Konik-ai/Konik-openpilot-harness-cables/car_harness/v1 (26pin_cables)/Ford_Q4_harness.pdf

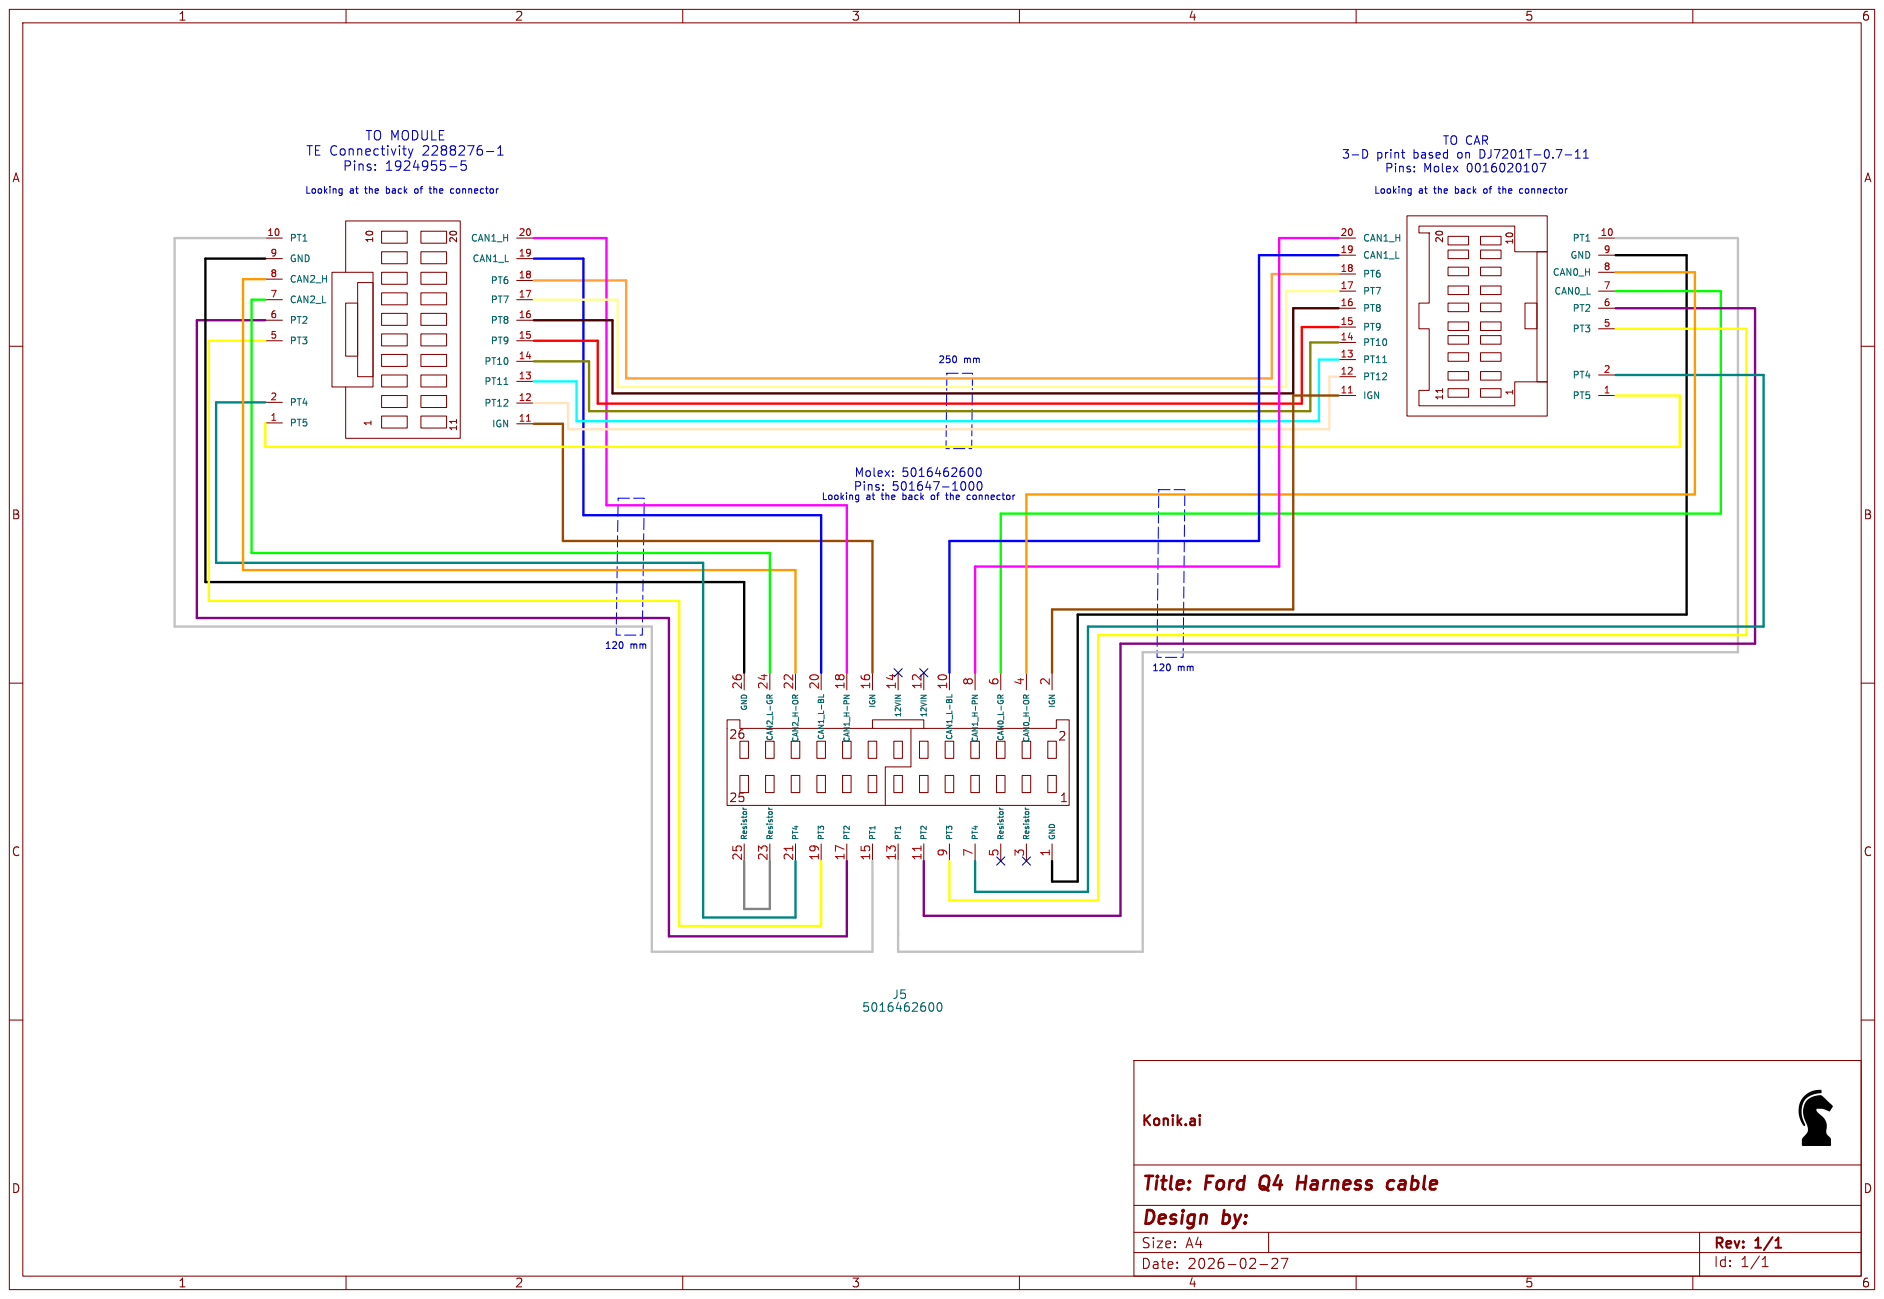
[picture p1: page 1]

3-D print based on DJ7201T-0.7-11 Pins: Molex 0016020107

Konik.ai Design by:

Id: 1/1 Title: Ford Q4 Harness cable
