Konik-ai/Konik-openpilot-harness-cables/car_harness/v1 (26pin_cables)/Bosch-C_harness.pdf

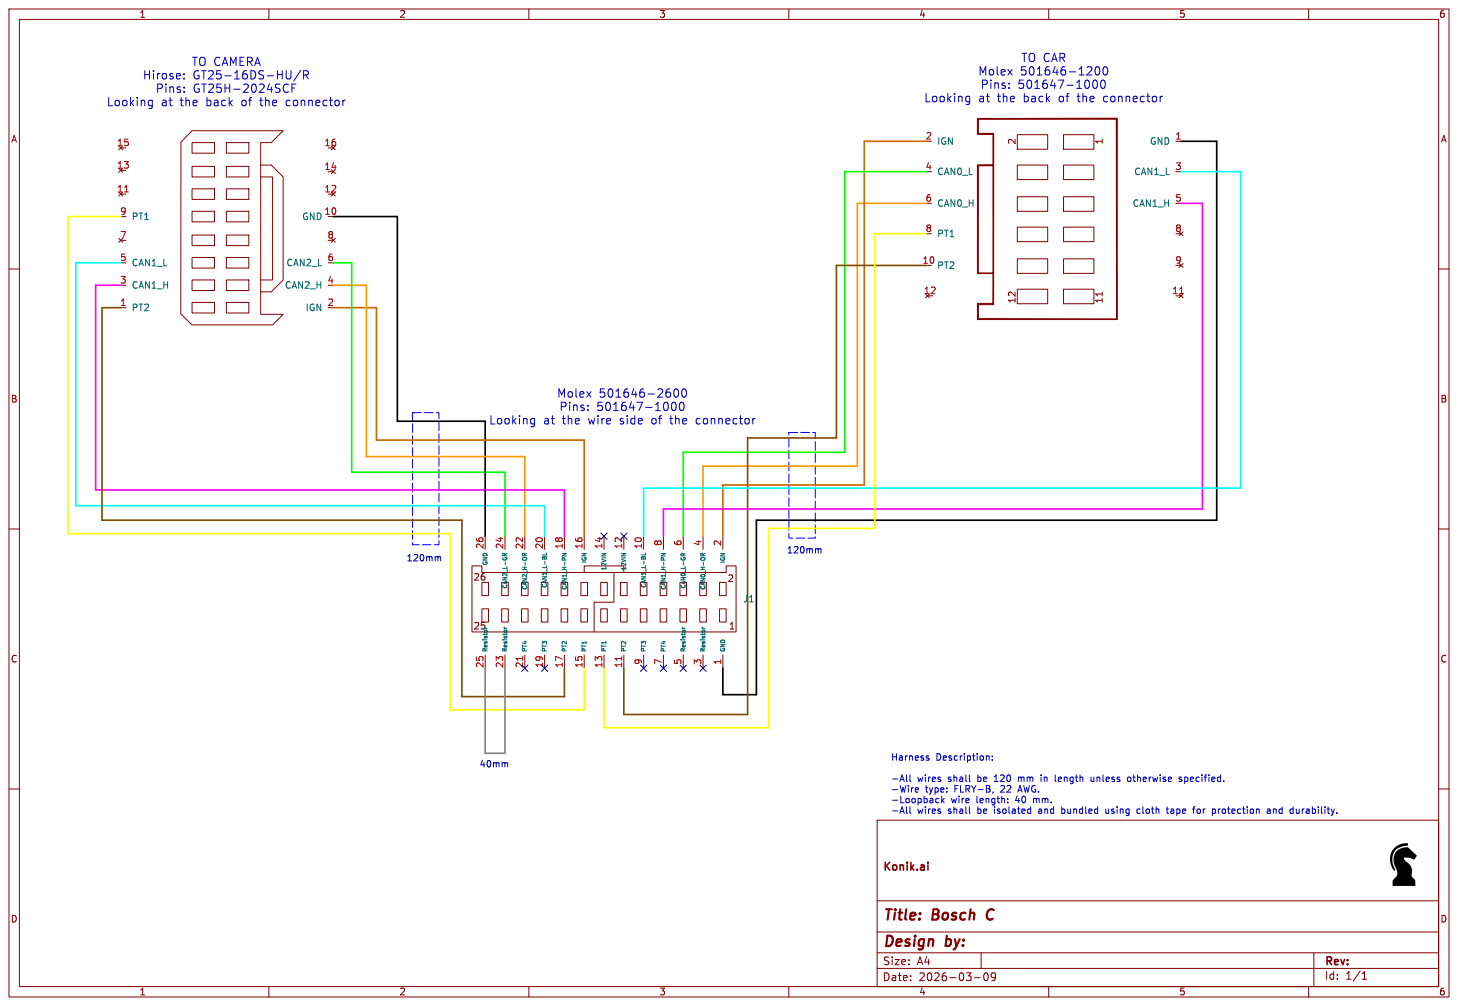
[picture p2: page 1]

Looking at the back of the connector TO CAMERA

Konik.ai Design by:
