Konik-ai/Konik-openpilot-harness-cables/car_harness/v1 (26pin_cables)/Hyundai_AKLM.pdf

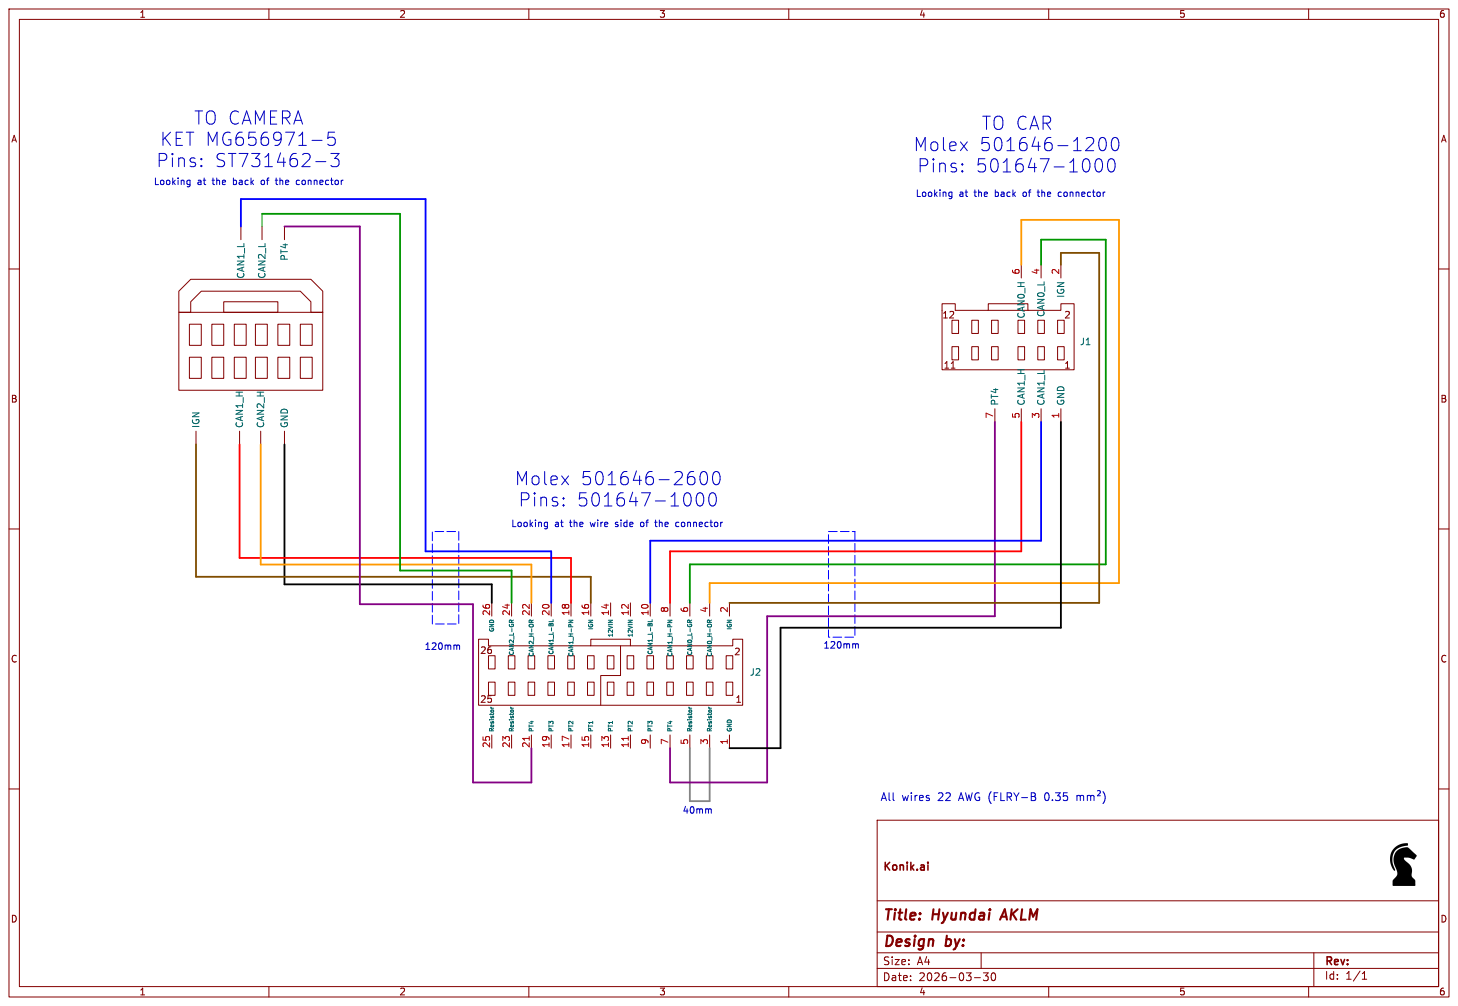
[picture p3: page 1]

Looking at the wire side of the connector

Konik.ai Design by:

Id: 1/1 Title: Hyundai AKLM
