Konik-ai/Konik-openpilot-harness-cables/car_harness/v1 (26pin_cables)/Hyundai_BEGI.pdf

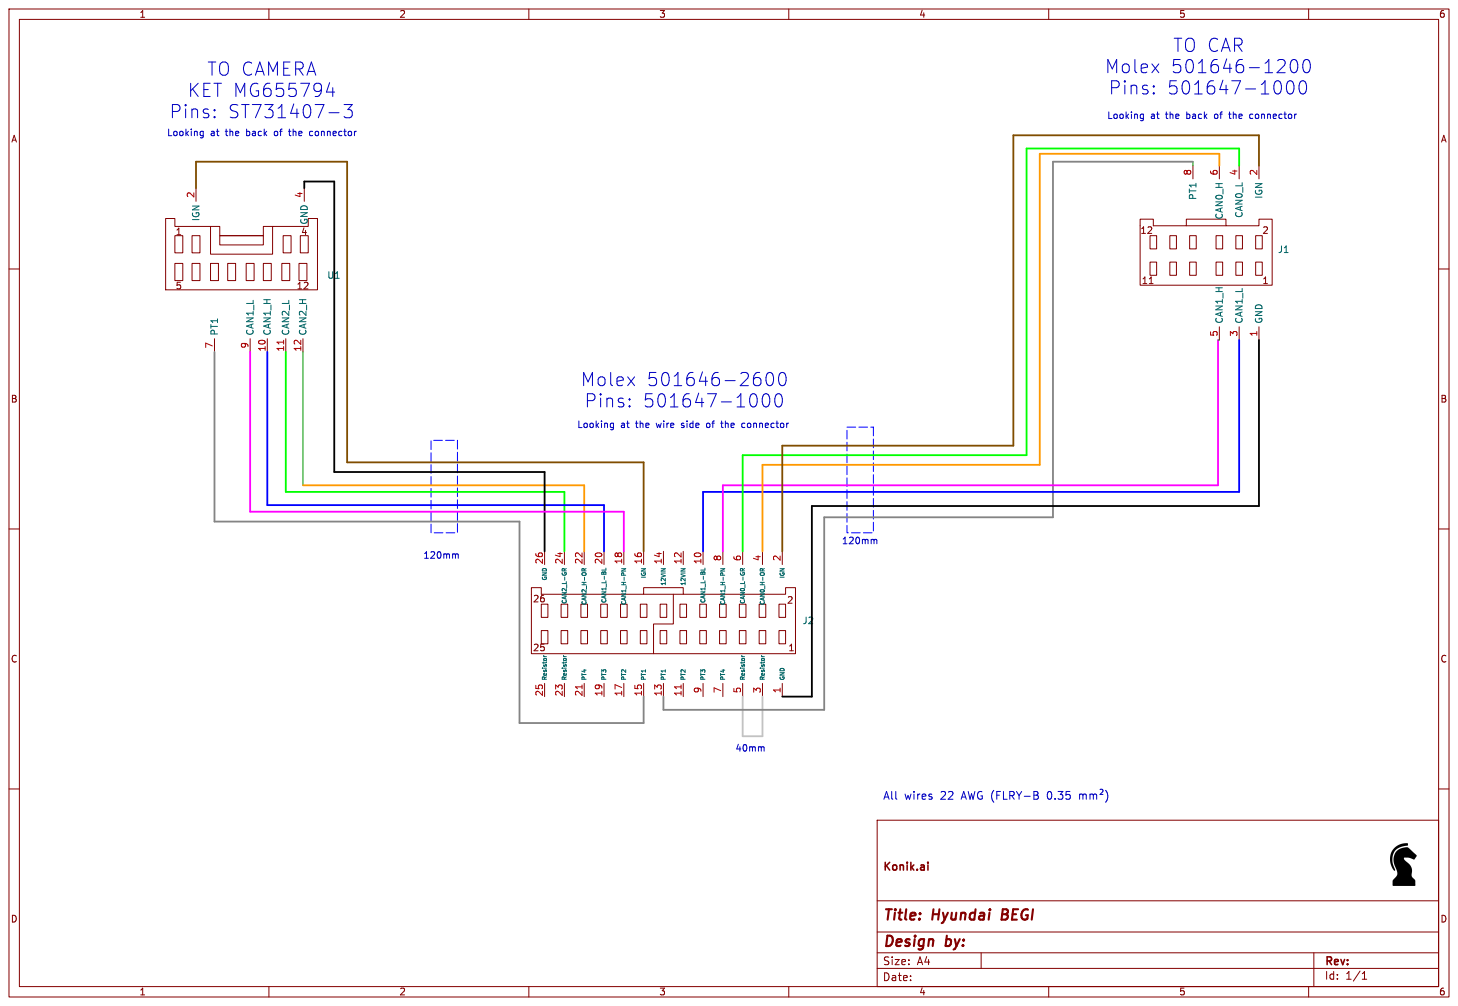
[picture p4: page 1]

Looking at the wire side of the connector

Id: 1/1 Title: Hyundai BEGI Konik.ai Design by:
