Konik-ai/Konik-openpilot-harness-cables/car_harness/v1 (26pin_cables)/Hyundai_CDFH.pdf

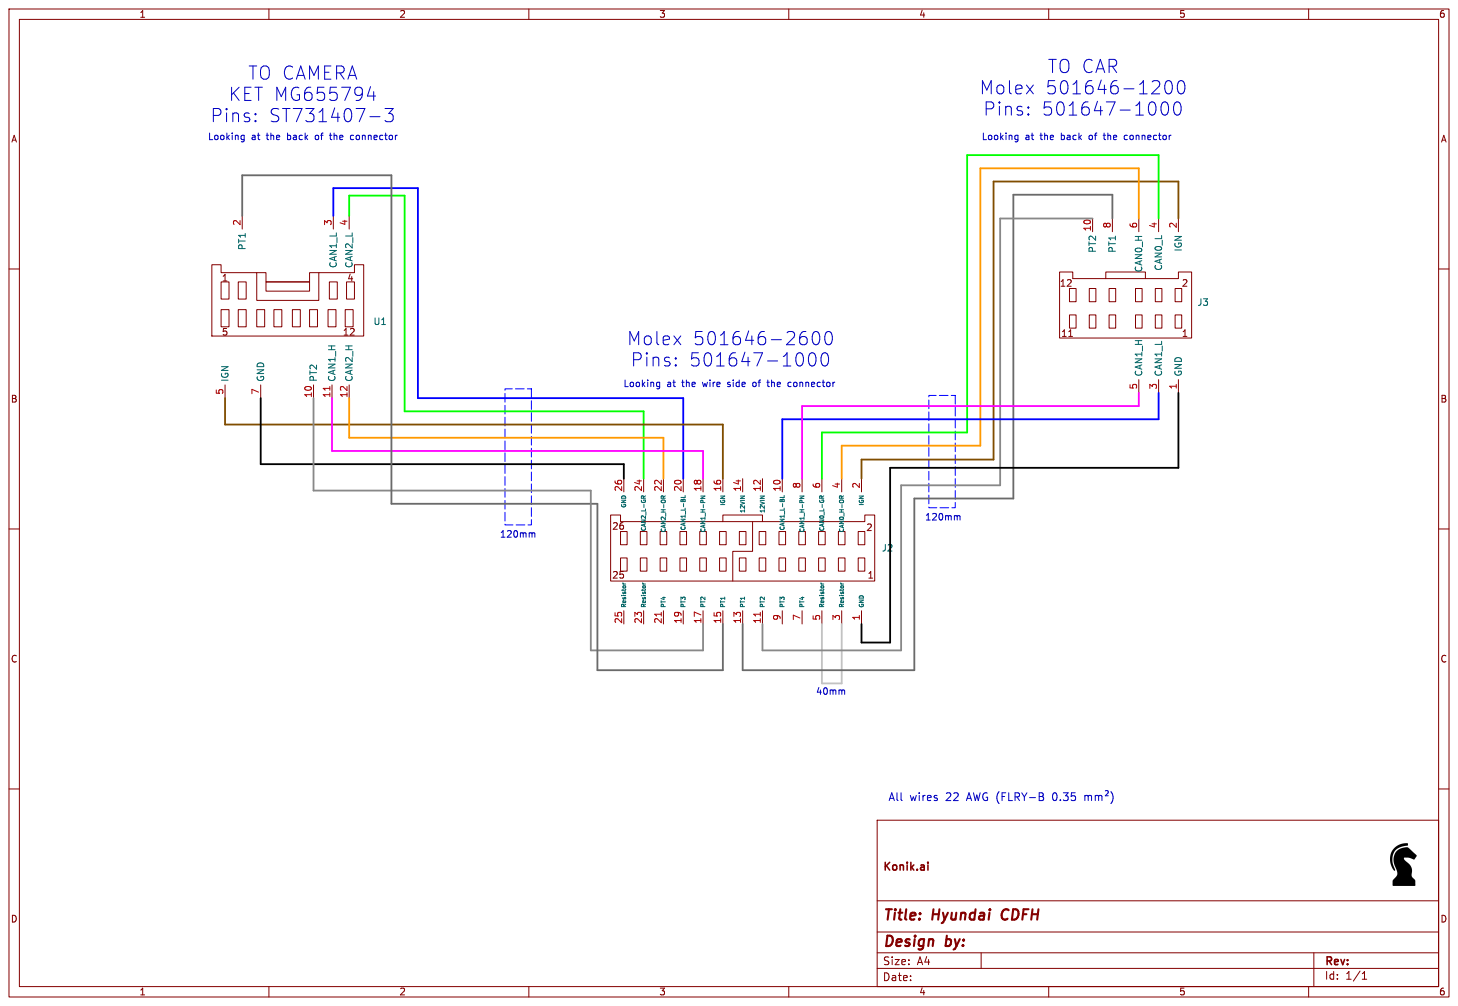
[picture p5: page 1]

Looking at the back of the connector

Looking at the back of the connector Molex 501646-2600

Konik.ai Design by:

Id: 1/1 Title: Hyundai CDFH
