Konik-ai/Konik-openpilot-harness-cables/car_harness/v1 (26pin_cables)/Hyundai_PQR.pdf

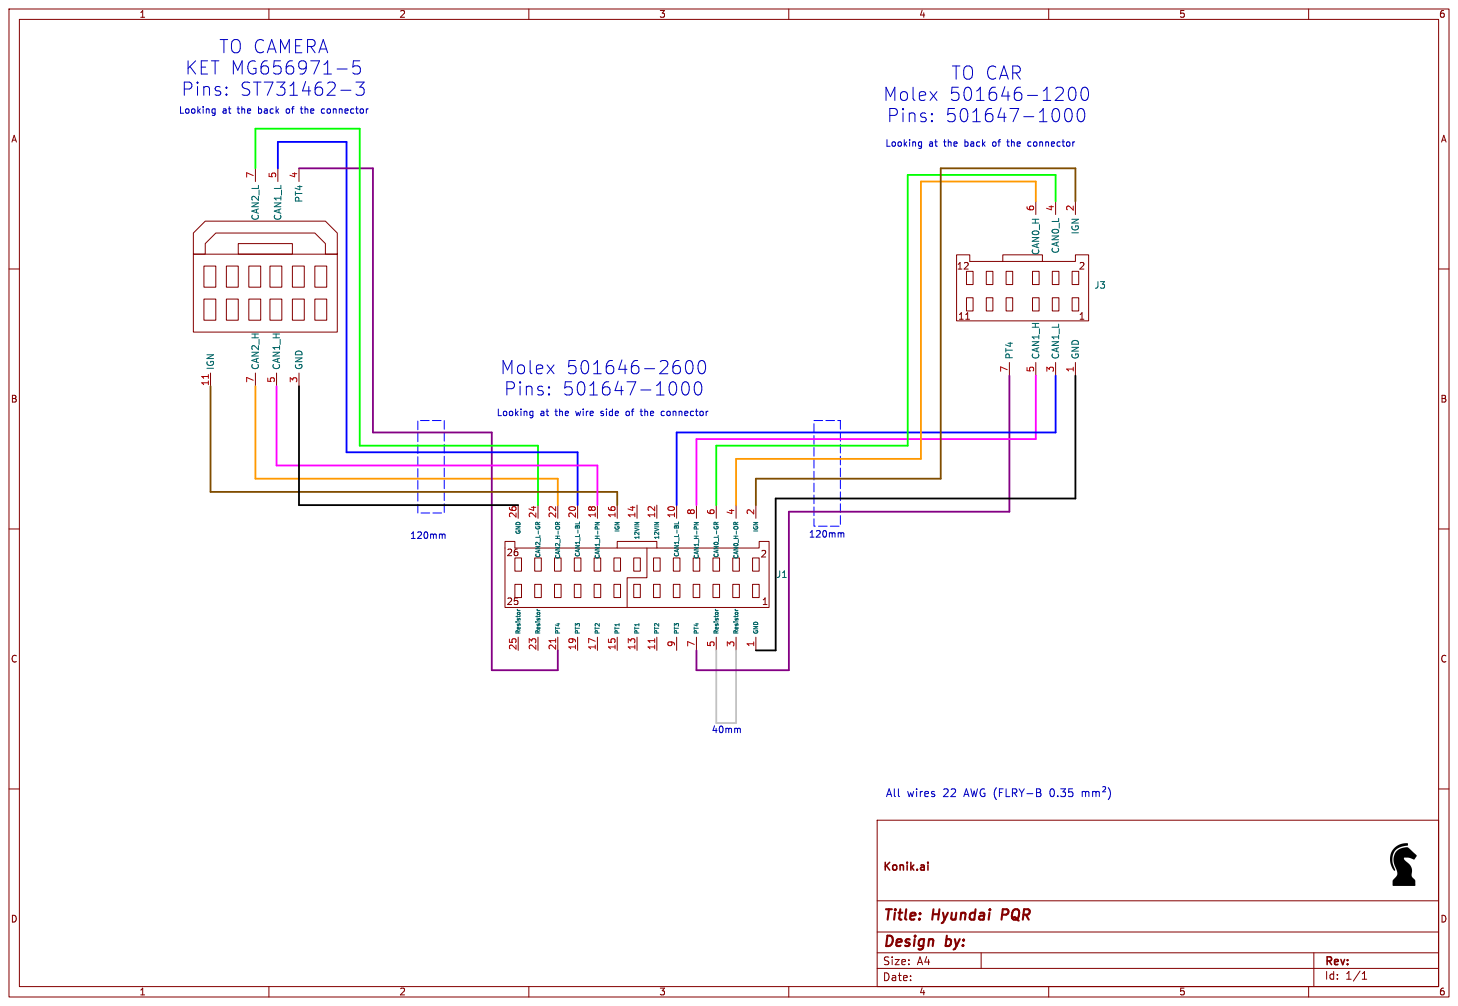
[picture p6: page 1]

Looking at the back of the connector TO CAMERA
KET MG656971-5
Pins: ST731462-3

Looking at the back of the connector 120mm

Looking at the wire side of the connector

Id: 1/1 Title: Hyundai PQR
