Konik-ai/Konik-openpilot-harness-cables/car_harness/v1 (26pin_cables)/BYD-1_Harness.pdf

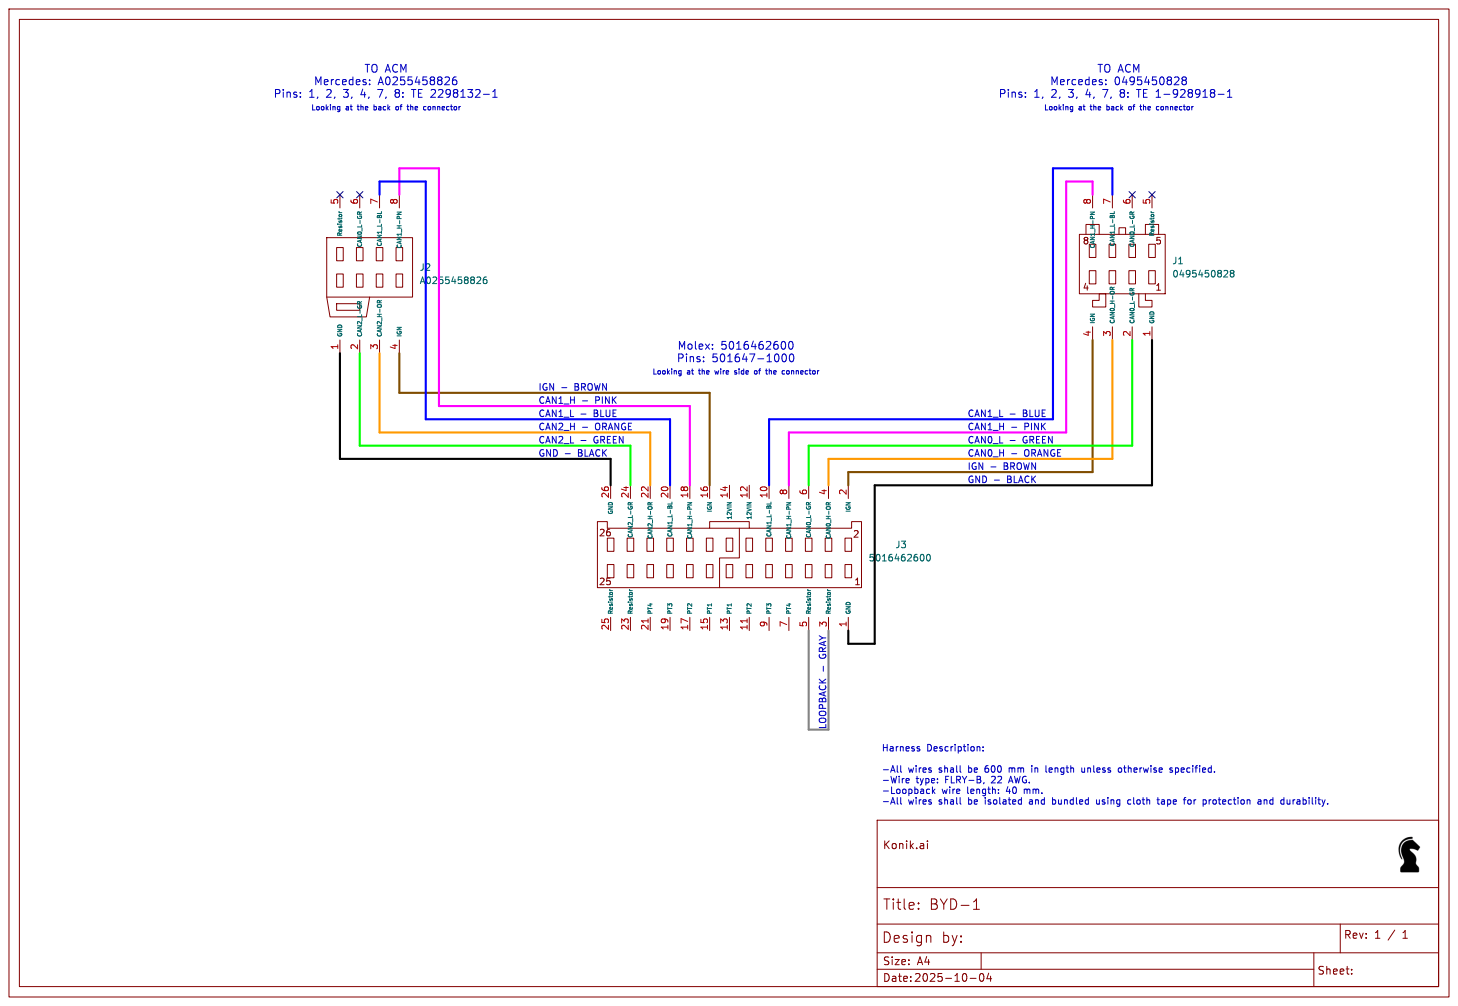
[picture p7: page 1]

Mercedes: 0495450828 Pins: 1, 2, 3, 4, 7, 8: TE 1-928918-1 TO ACM

Looking at the back of the connector TO ACM

IGN - BROWN
CAN1_L - BLUE GND - BLACK LOOPBACK - GRAY GND - BLACK CAN1_H - PINK
CAN1_L - BLUE CAN2_L - GREEN
