Konik-ai/Konik-openpilot-harness-cables/car_harness/v1 (26pin_cables)/BYD-2_Harness.pdf

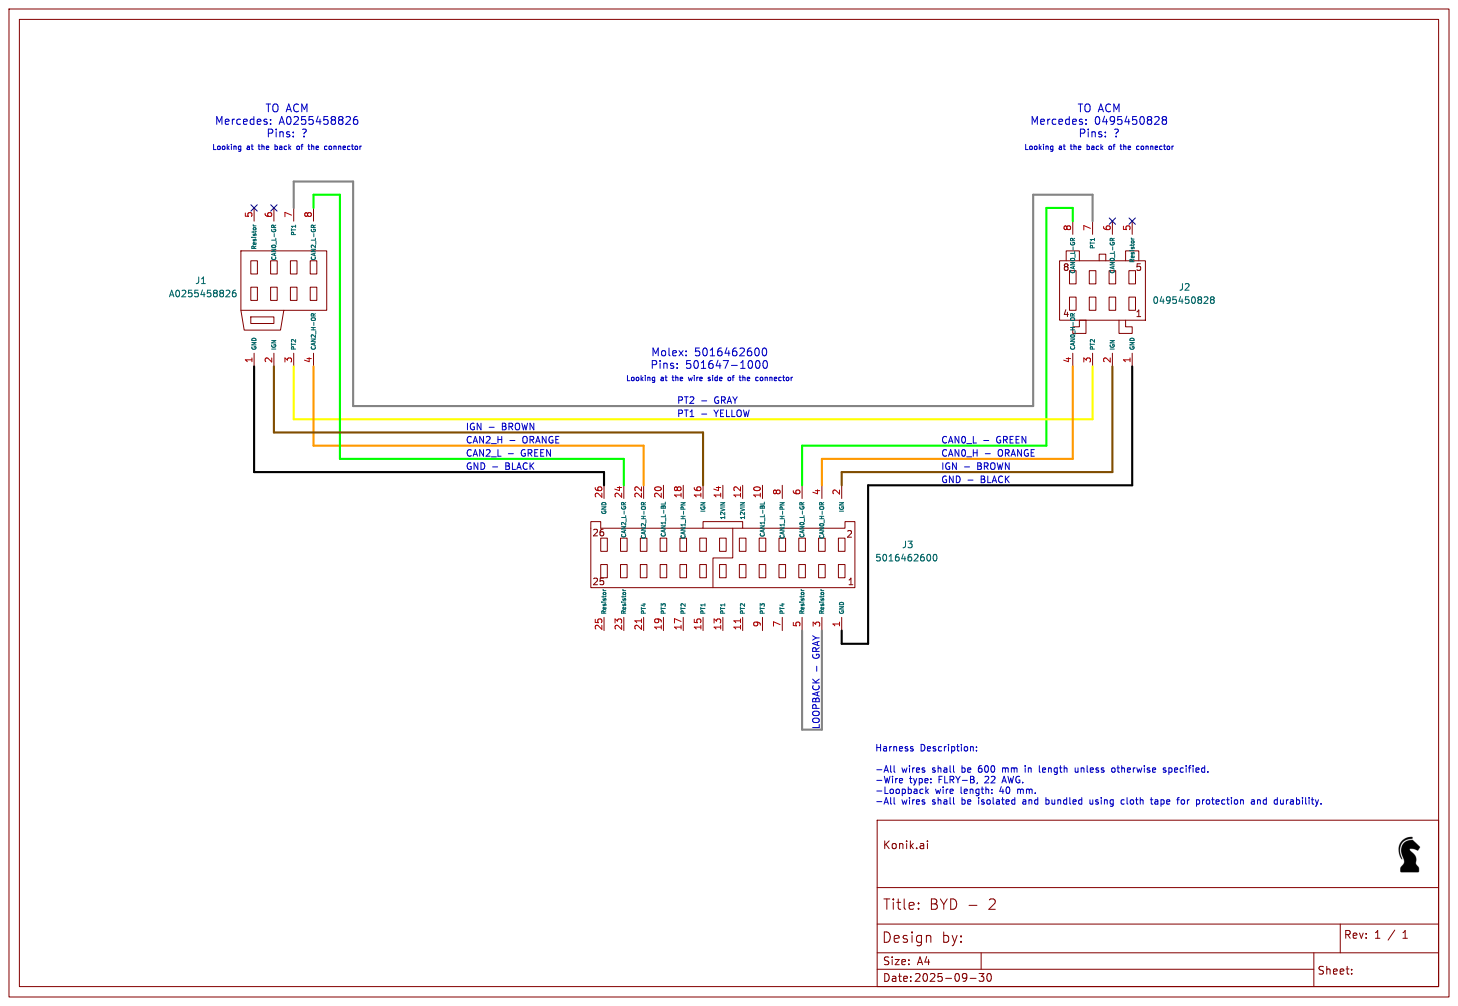
[picture p8: page 1]

Mercedes: 0495450828 Pins: ? TO ACM

Looking at the wire side of the connector Looking at the back of the connector
