Konik-ai/Konik-openpilot-harness-cables/car_harness/v1 (26pin_cables)/BYD-3_Harness.pdf

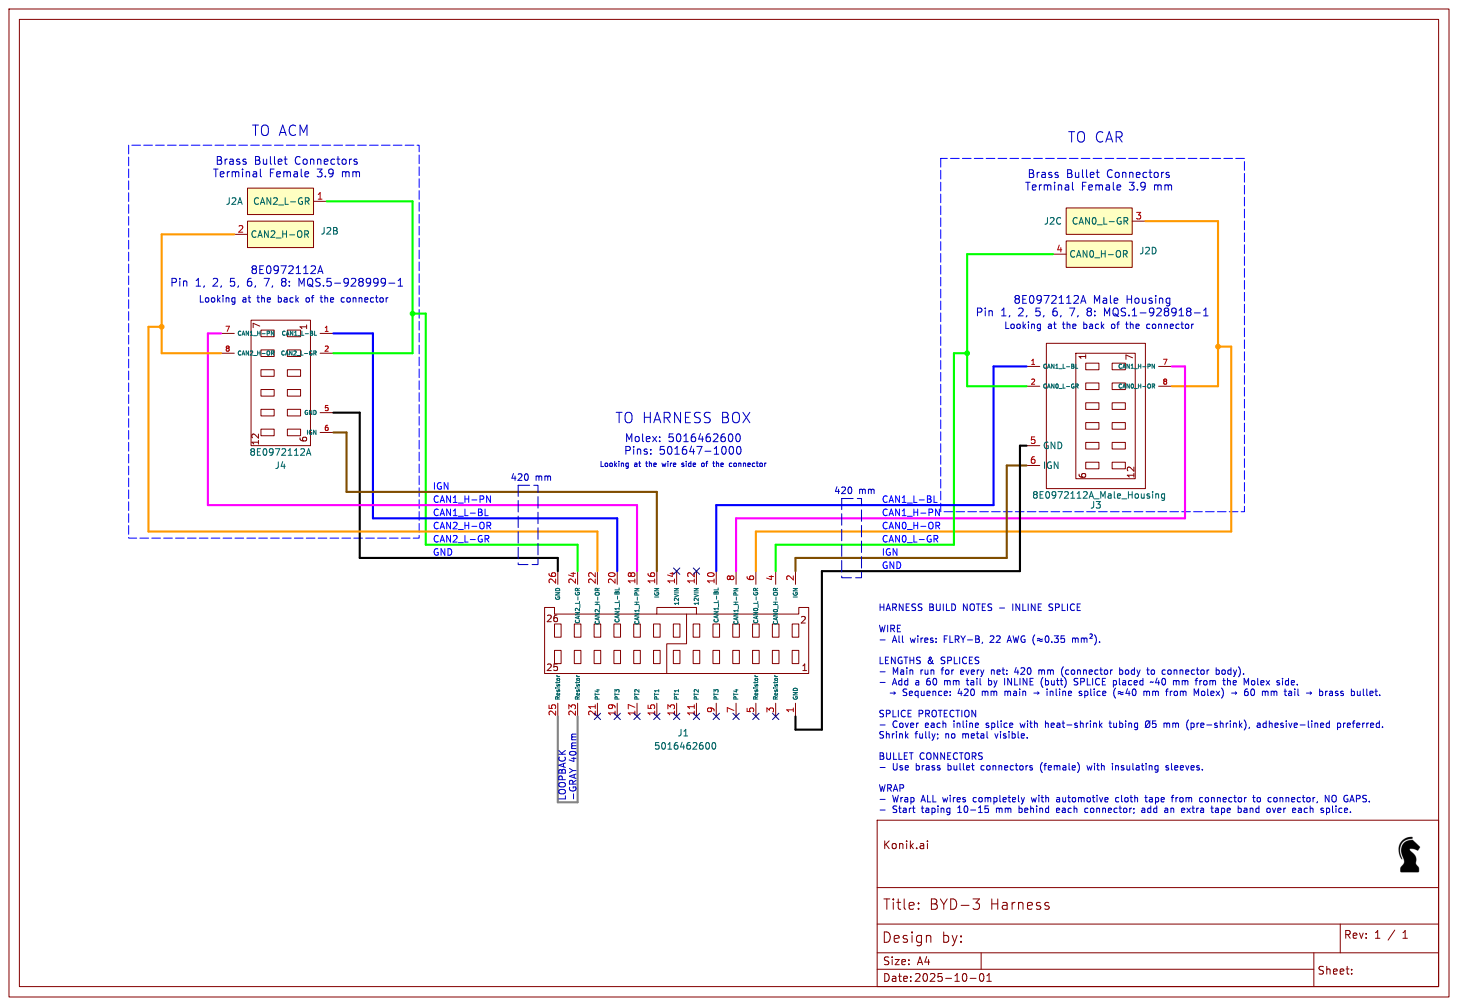
[picture p9: page 1]

Brass Bullet Connectors Terminal Female 3.9 mm

Looking at the back of the connector 420 mm

Looking at the wire side of the connector Molex: 5016462600 Pins: 501647-1000 TO HARNESS BOX

- All wires: FLRY-B, 22 AWG þÿ("H0.35 þÿmm²). LENGTHS & SPLICES
