Konik-ai/Konik-openpilot-harness-cables/car_harness/v1 (26pin_cables)/BYD-4_Harness.pdf

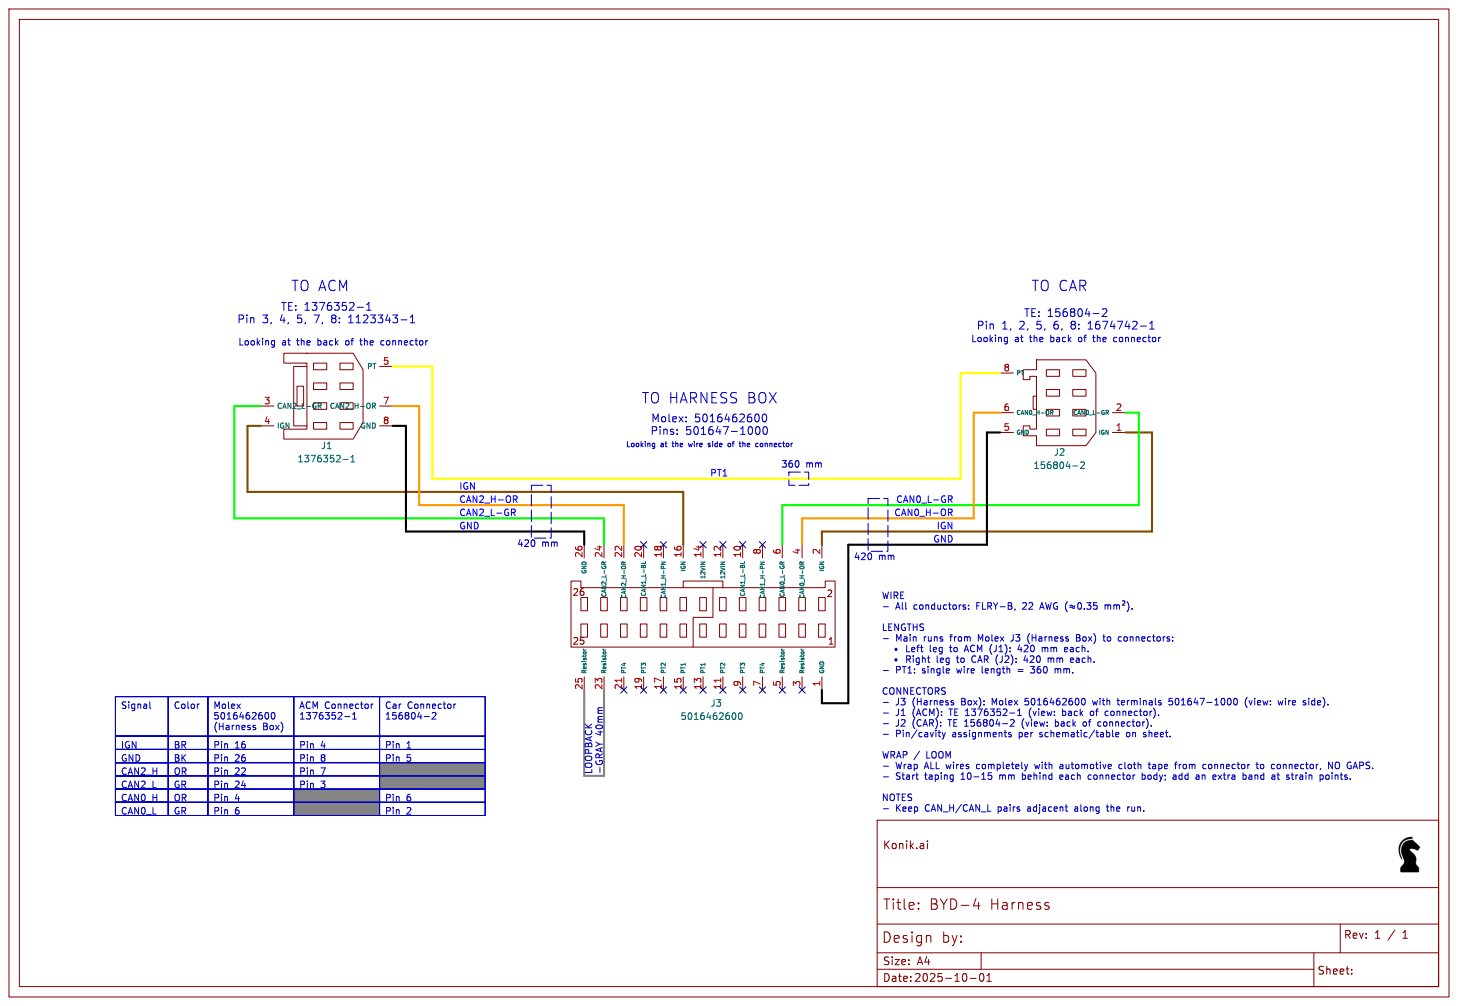
[picture p10: page 1]

TE: 156804-2 Pin 1, 2, 5, 6, 8: 1674742-1 Molex: 5016462600 Pins: 501647-1000

360 mm TO HARNESS BOX

- Main runs from Molex J3 (Harness Box) to connectors: þÿ "Left leg to ACM (J1): 420 mm each. þÿ "Right leg to CAR (J2): 420 mm each. - PT1: single wire length = 360 mm. CONNECTORS
