Konik-ai/Konik-openpilot-harness-cables/car_harness/v1 (26pin_cables)/BYD-5_Harness.pdf

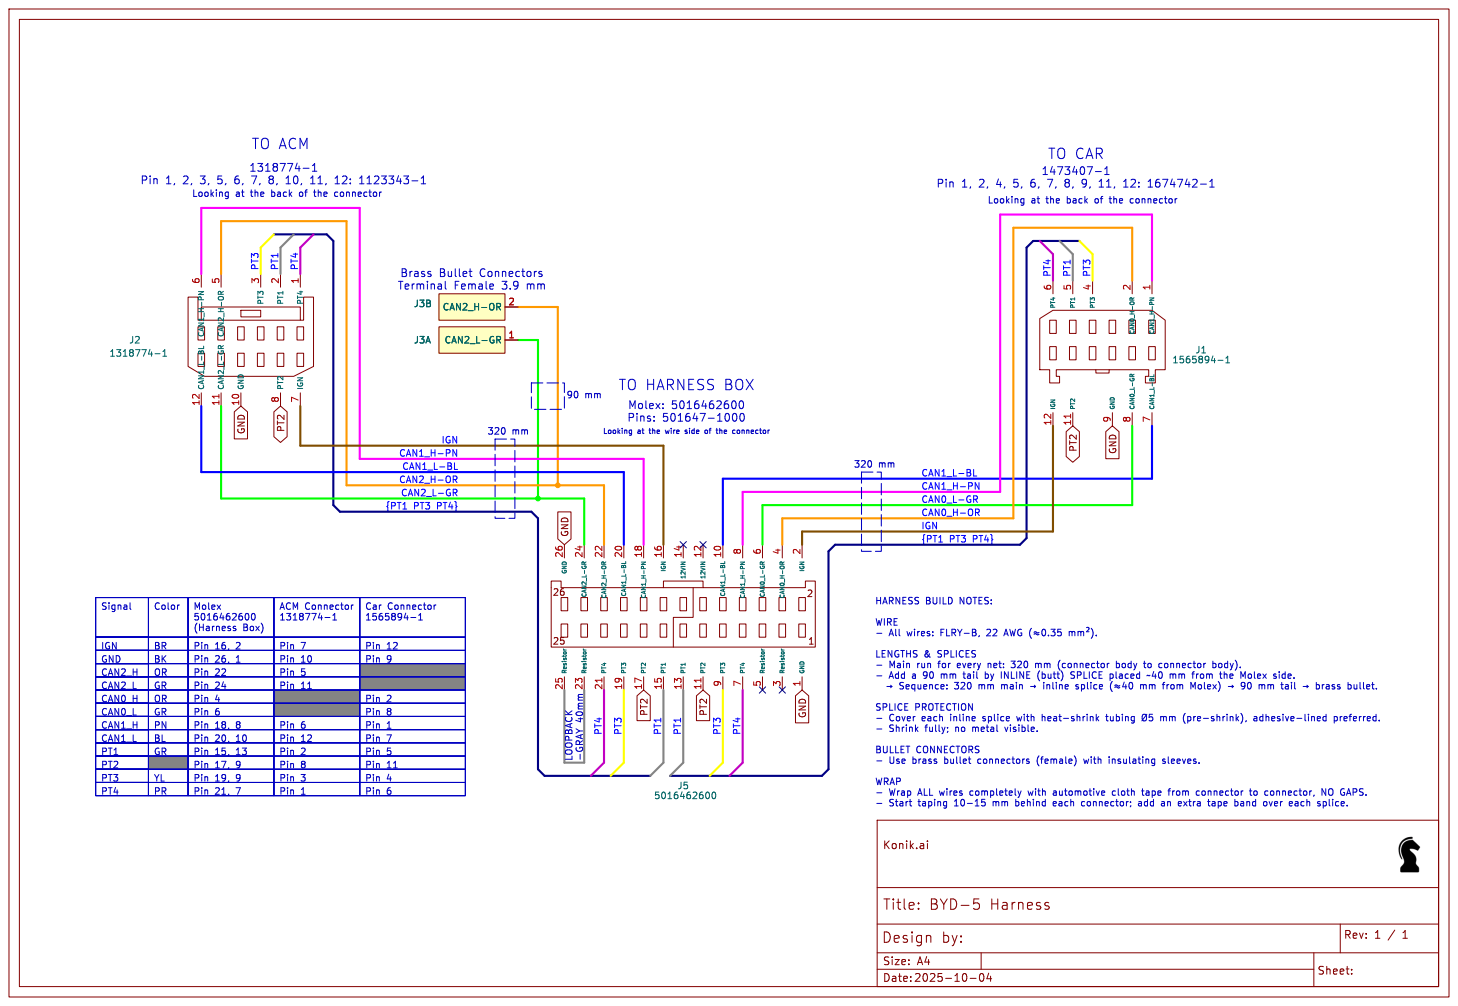
[picture p11: page 1]

1473407-1 Pin 1, 2, 4, 5, 6, 7, 8, 9, 11, 12: 1674742-1 Brass Bullet Connectors Terminal Female 3.9 mm

Looking at the back of the connector LOOPBACK -GRAY 40mm

HARNESS BUILD NOTES: WIRE

- All wires: FLRY-B, 22 AWG þÿ("H0.35 þÿmm²). LENGTHS & SPLICES
