Konik-ai/Konik-openpilot-harness-cables/car_harness/v1 (26pin_cables)/BYD-6_Harness.pdf

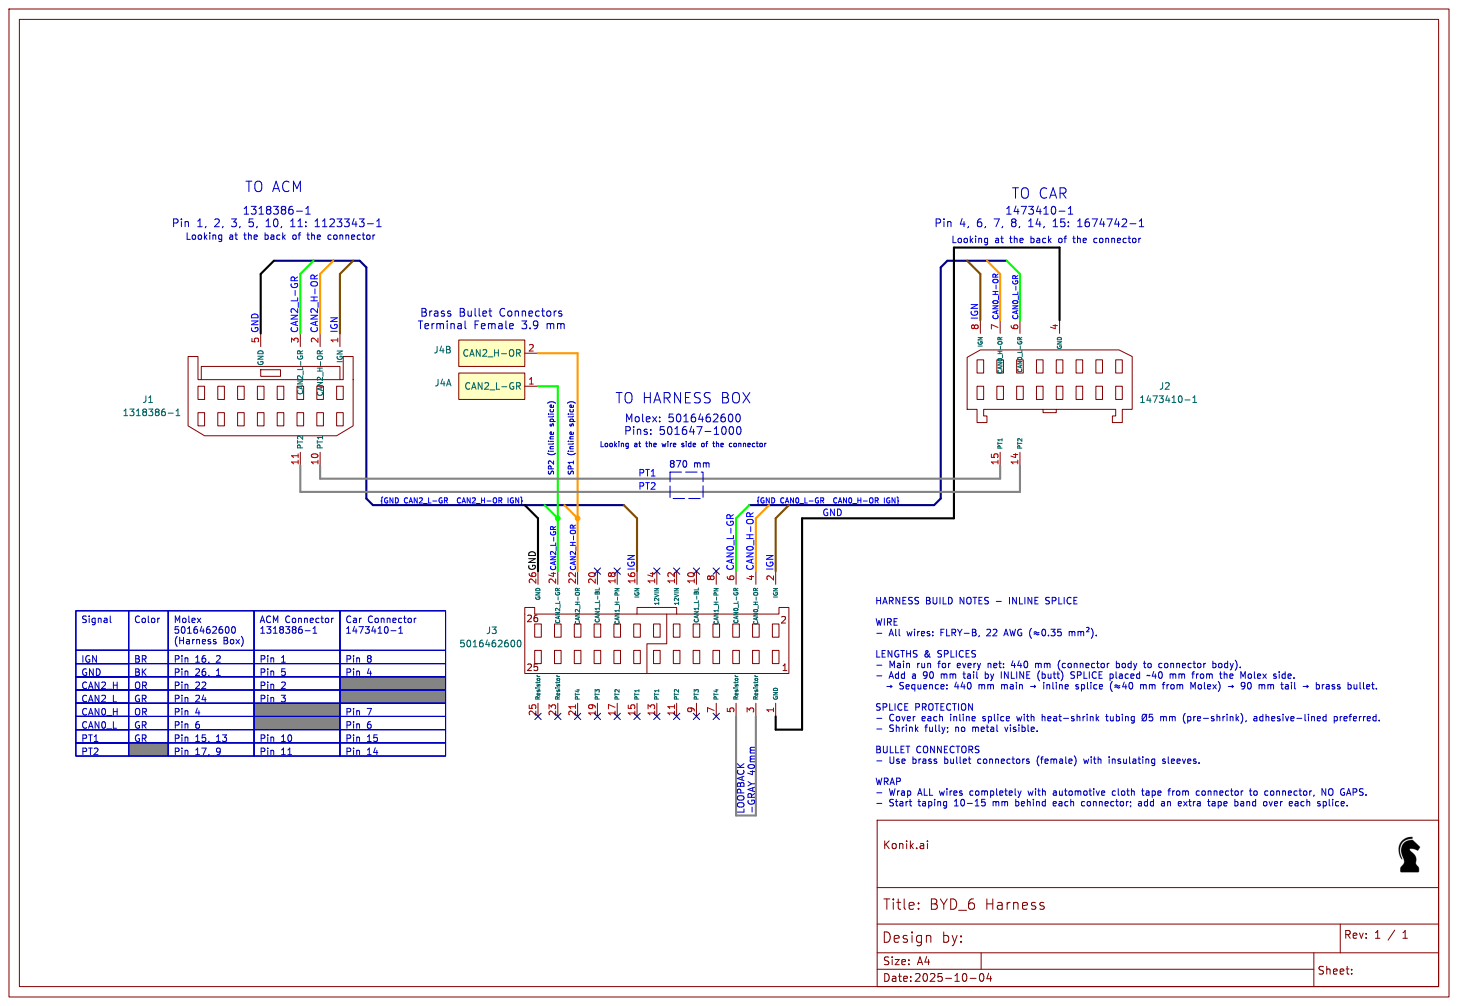
[picture p12: page 1]

Molex: 5016462600 Pins: 501647-1000 LOOPBACK -GRAY 40mm

Brass Bullet Connectors Terminal Female 3.9 mm

Looking at the wire side of the connector TO HARNESS BOX

HARNESS BUILD NOTES - INLINE SPLICE WIRE

- All wires: FLRY-B, 22 AWG þÿ("H0.35 þÿmm²). LENGTHS & SPLICES
