Konik-ai/Konik-openpilot-harness-cables/car_harness/v1 (26pin_cables)/Tesla_A-HW4_V2_Harness.pdf

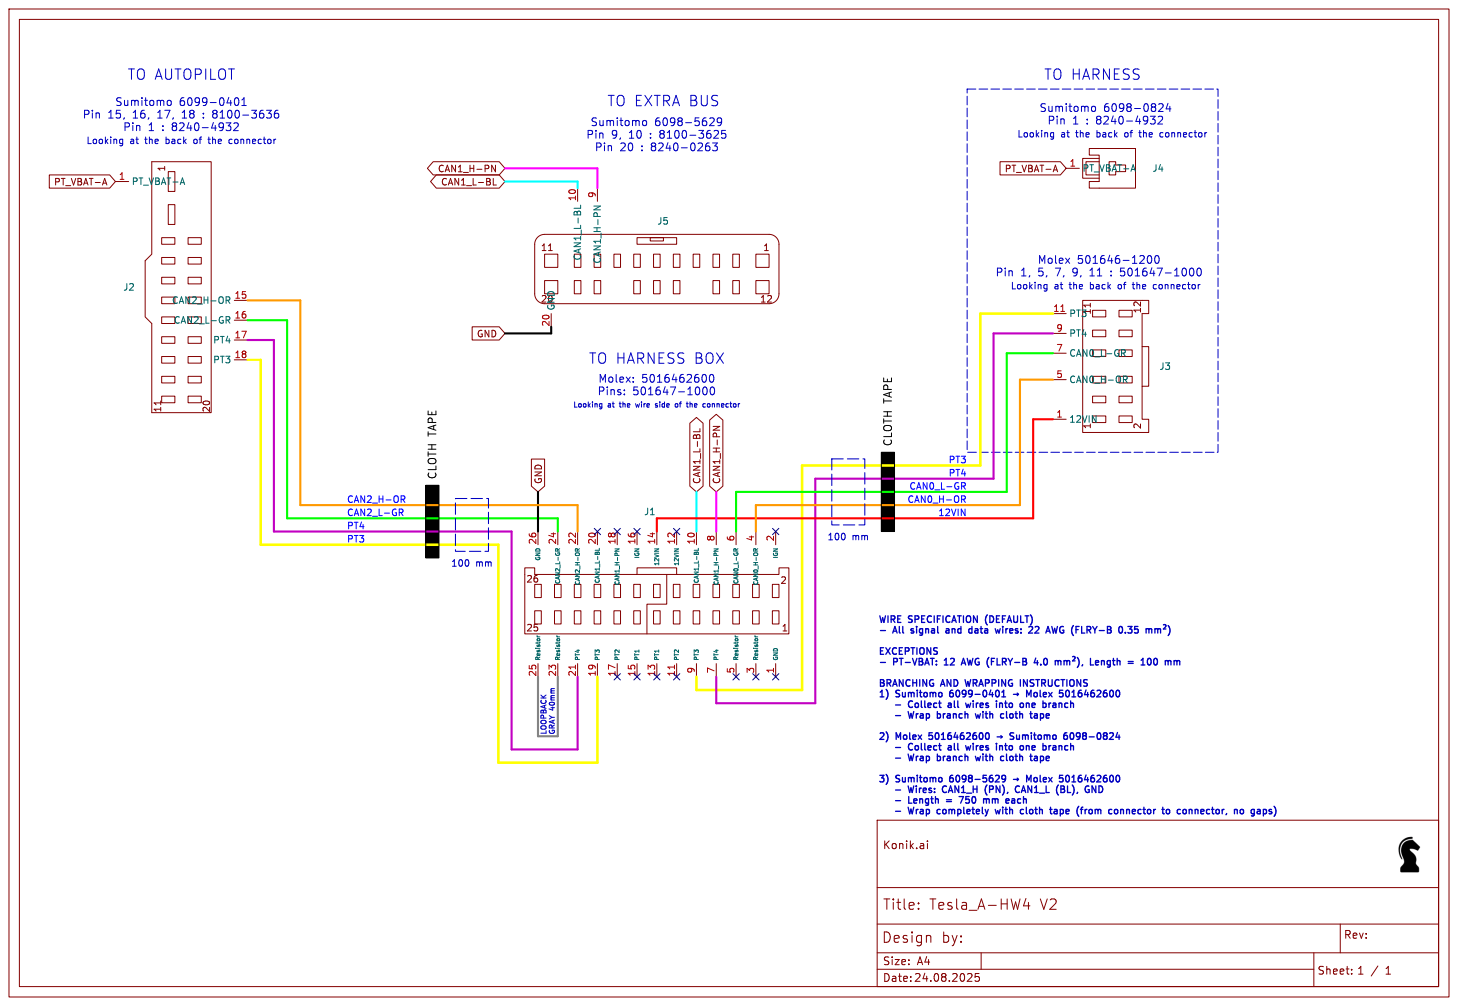
[picture p13: page 1]

Looking at the back of the connector
J3 PT_VBAT-A 1

BRANCHING AND WRAPPING INSTRUCTIONS
- Collect all wires into one branch
- Wrap branch with cloth tape

- Wires: CAN1_H (PN), CAN1_L (BL), GND
- Length = 750 mm each
- Wrap completely with cloth tape (from connector to connector, no gaps)
