Konik-ai/Konik-openpilot-harness-cables/car_harness/v1 (26pin_cables)/Rivian_A_Harness.pdf

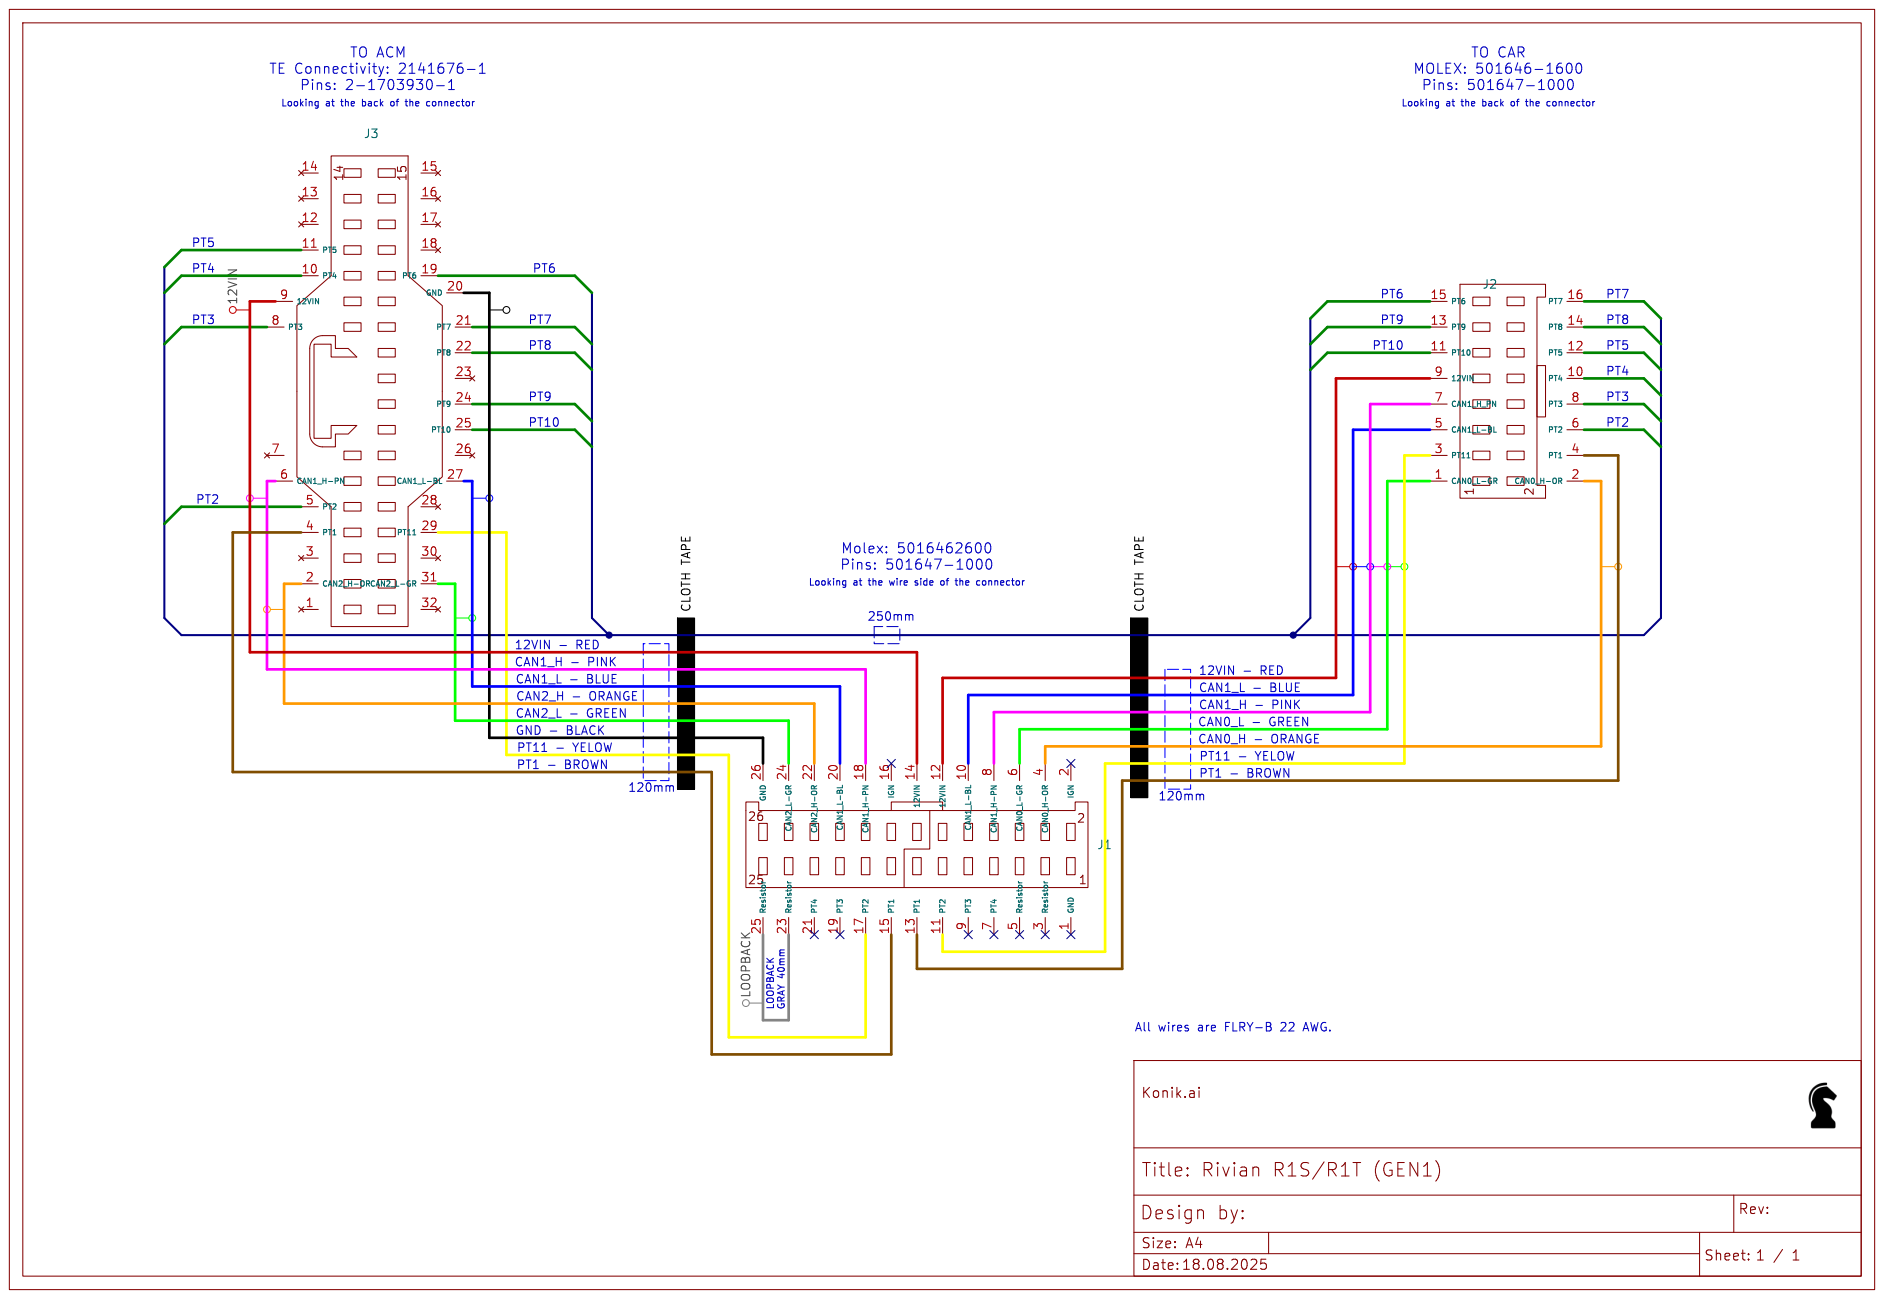
[picture p14: page 1]

TO CAR MOLEX: 501646-1600 Pins: 501647-1000 LOOPBACK GRAY 40mm CLOTH TAPE TO ACM

Looking at the wire side of the connector Molex: 5016462600 Pins: 501647-1000

All wires are FLRY-B 22 AWG.
