Konik-ai/Konik-openpilot-harness-cables/car_harness/v1 (26pin_cables)/Tesla_A_HW3_V1_Harness.pdf

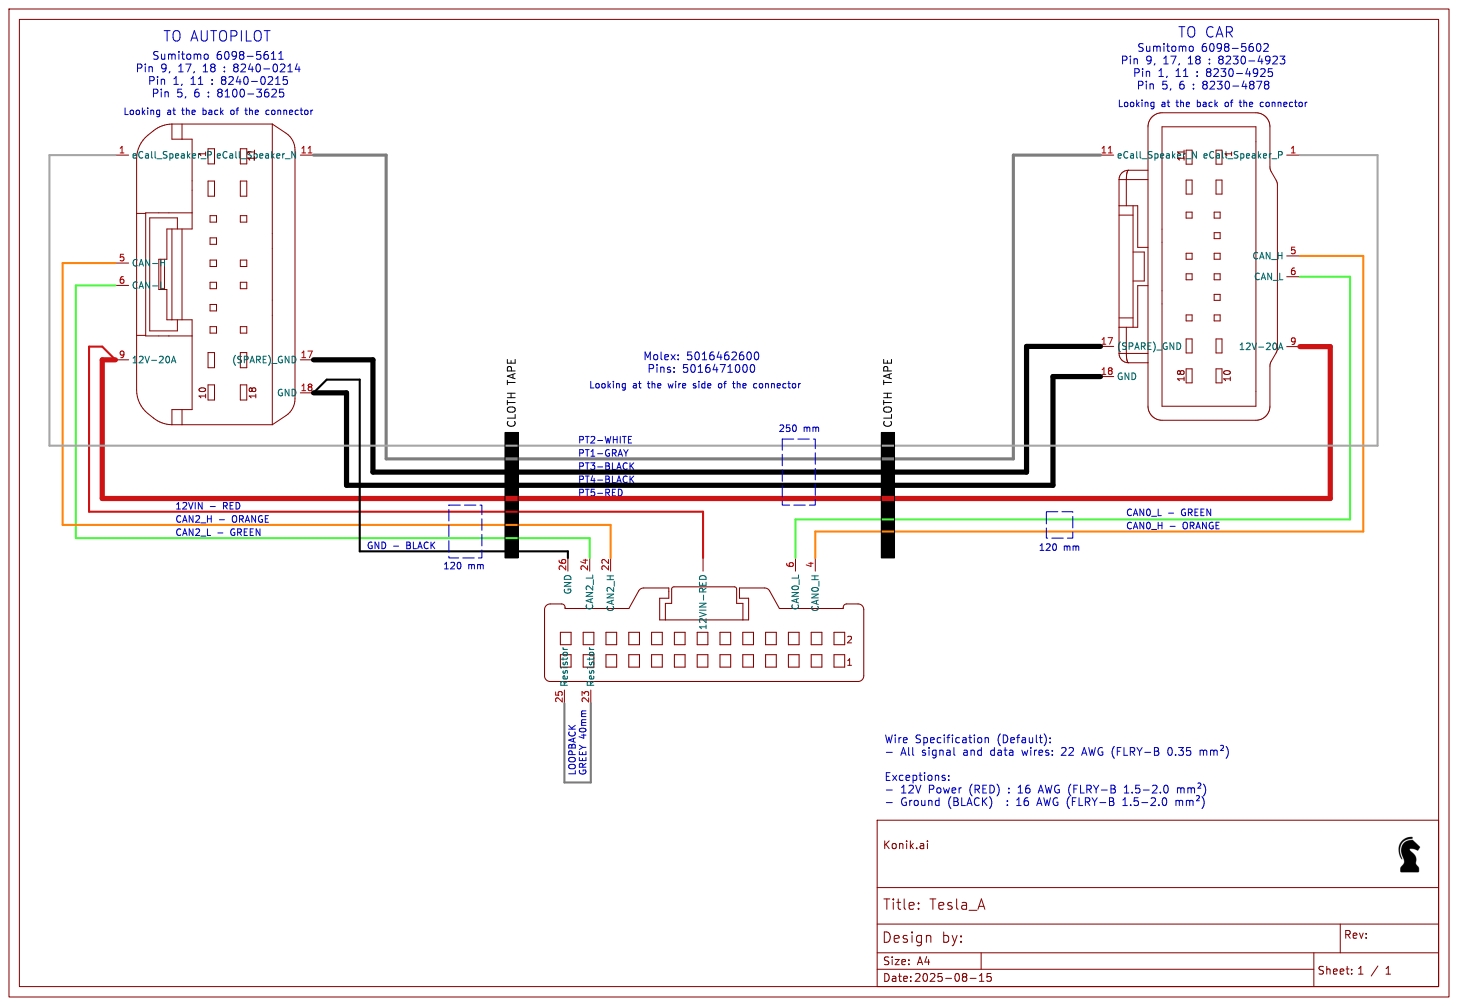
[picture p15: page 1]

Looking at the back of the connector 11 10 1 TO AUTOPILOT

PT1-GRAY
PT3-BLACK

CAN0_H - ORANGE

CAN2_L - GREEN
