Konik-ai/Konik-openpilot-harness-cables/car_harness/v1 (26pin_cables)/VW_MEB_Gateway_Harness.pdf

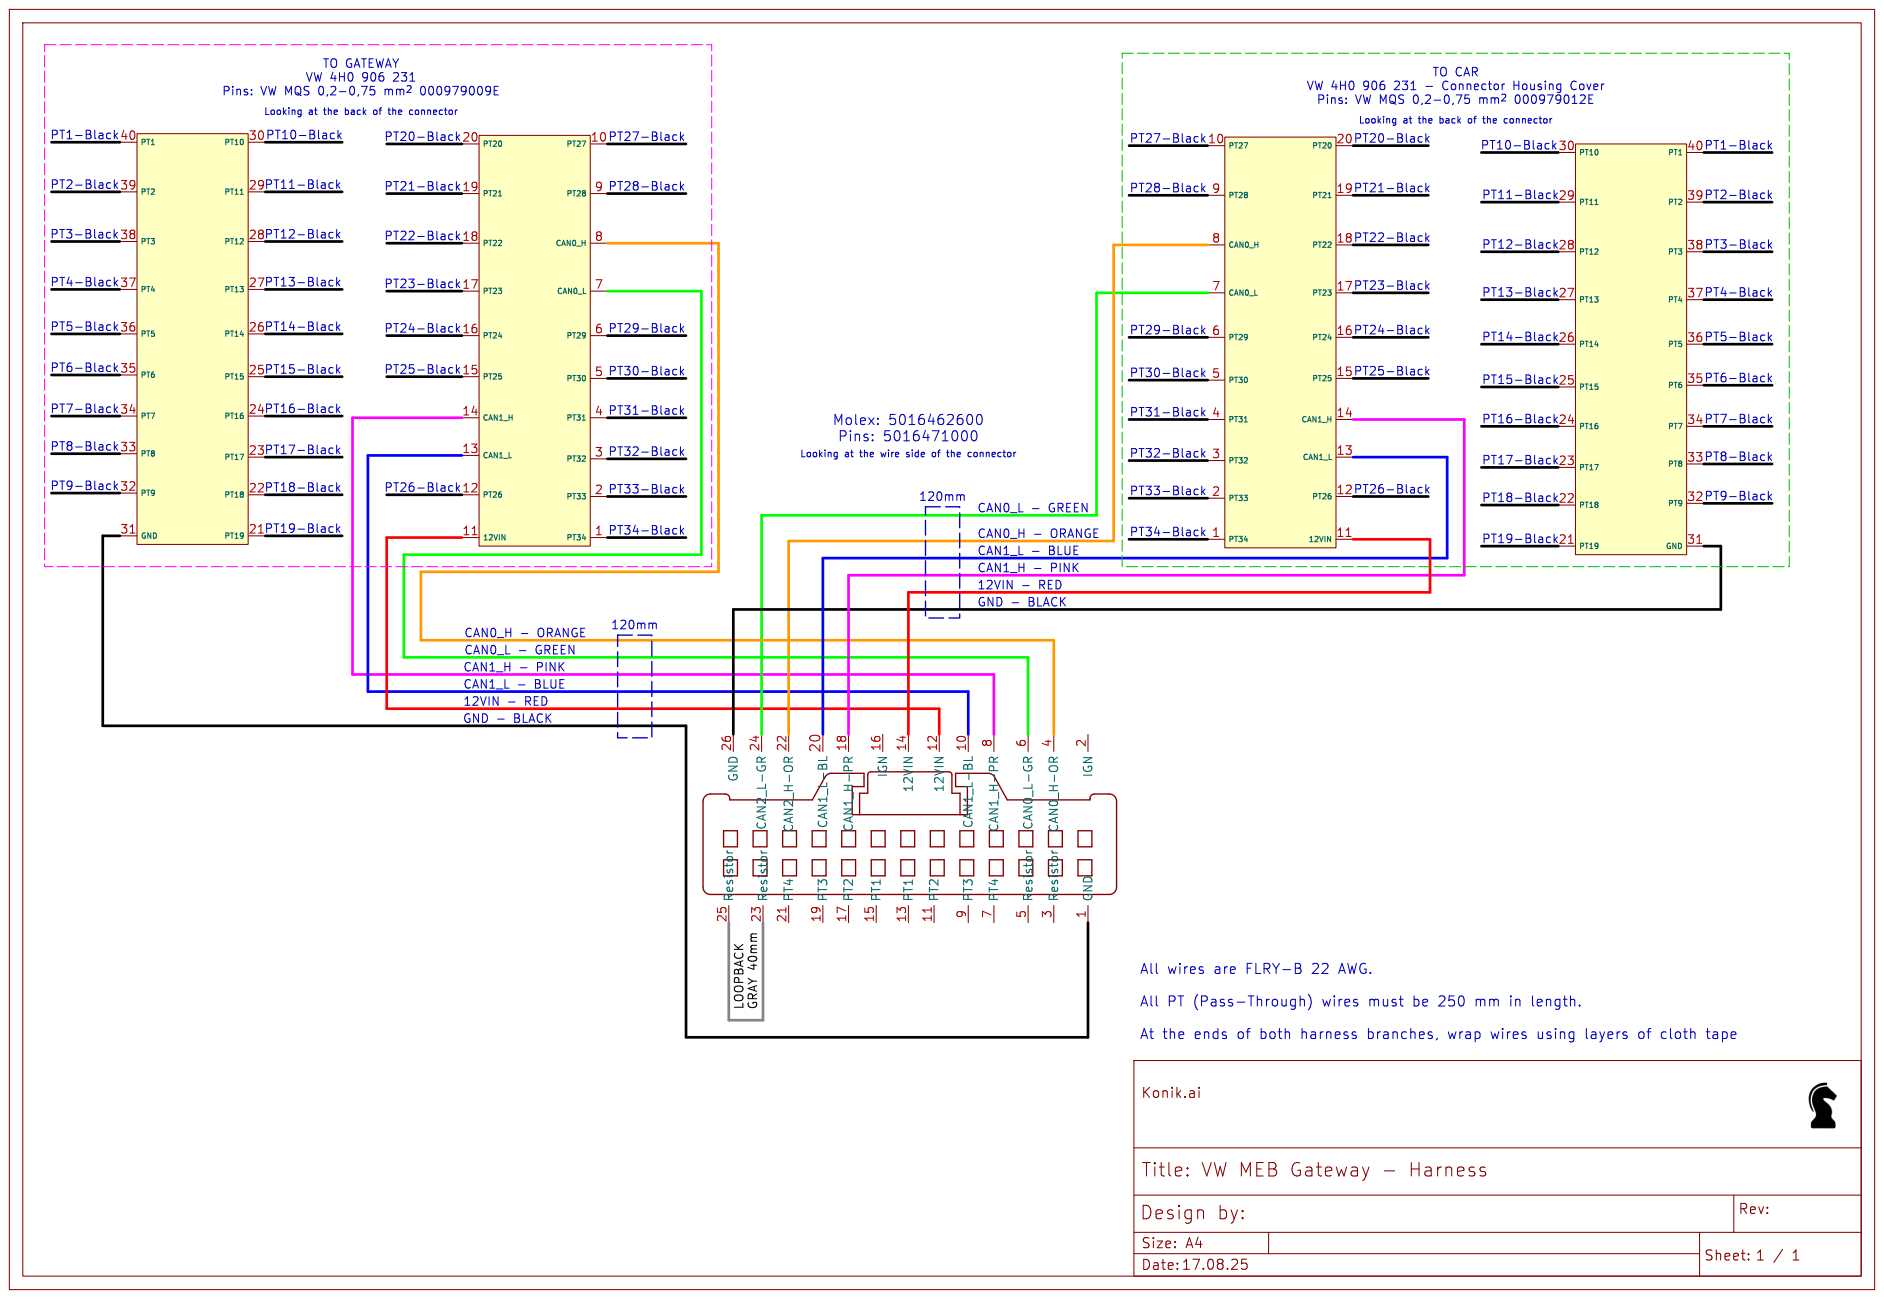
[picture p16: page 1]

Looking at the back of the connector TO GATEWAY

Looking at the back of the connector

Looking at the wire side of the connector 120mm
