Konik-ai/Konik-openpilot-harness-cables/car_harness/v1 (26pin_cables)/Hyundai_ON.pdf

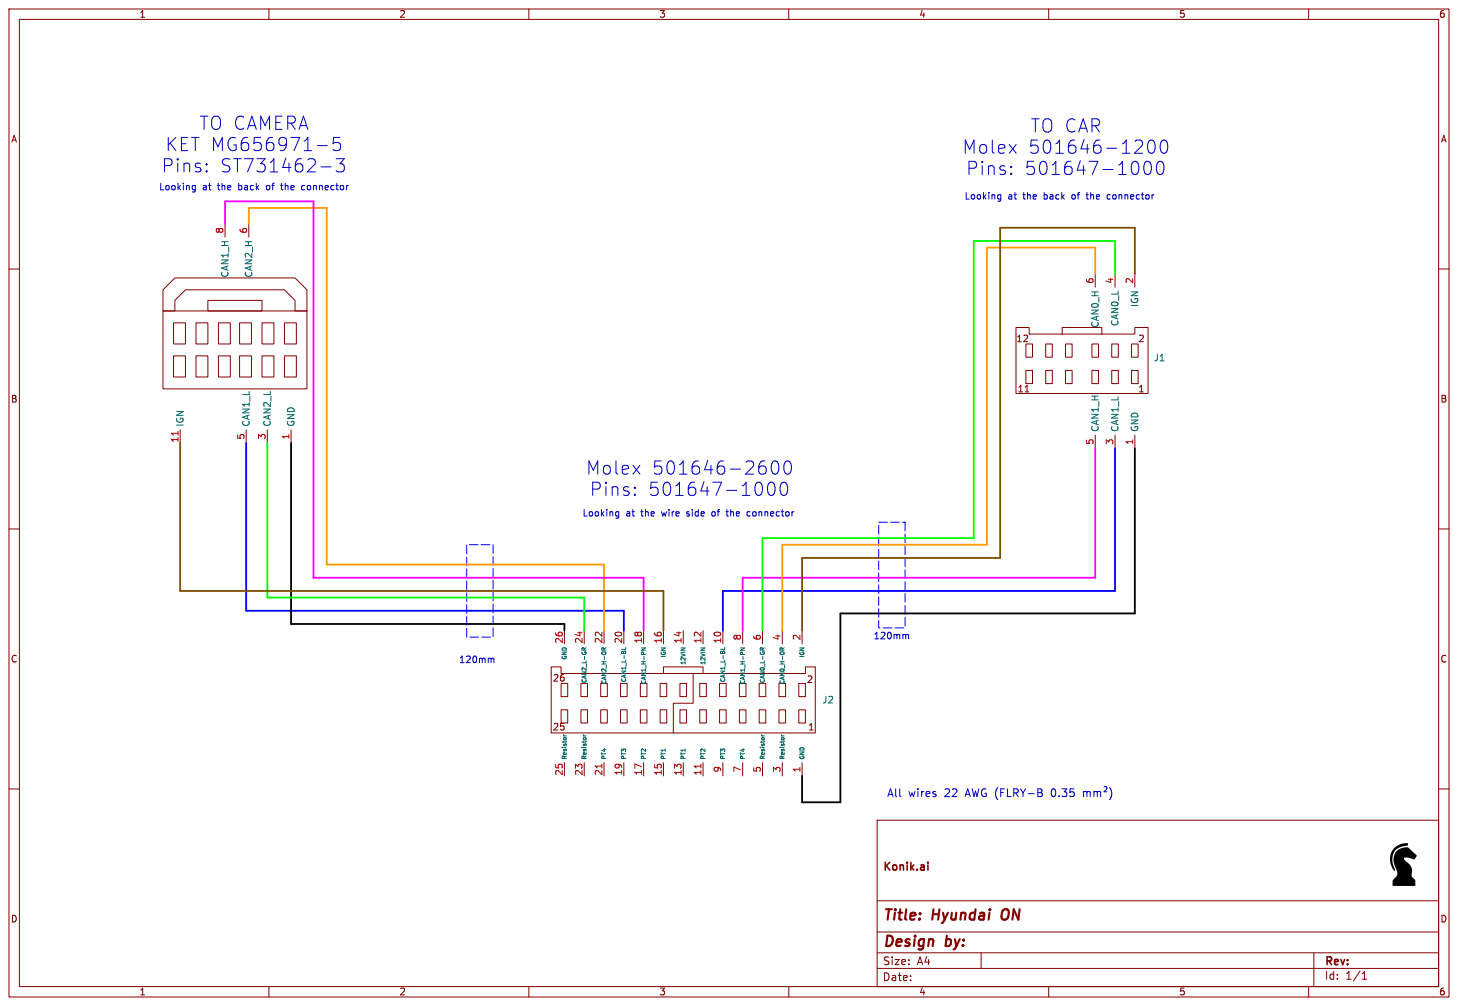
[picture p17: page 1]

Konik.ai Design by:

Id: 1/1 Title: Hyundai ON
