Konik-ai/Konik-openpilot-harness-cables/board/Hyundai/AKLM/Hyundai_adapter_AKLM-F_Cu.pdf

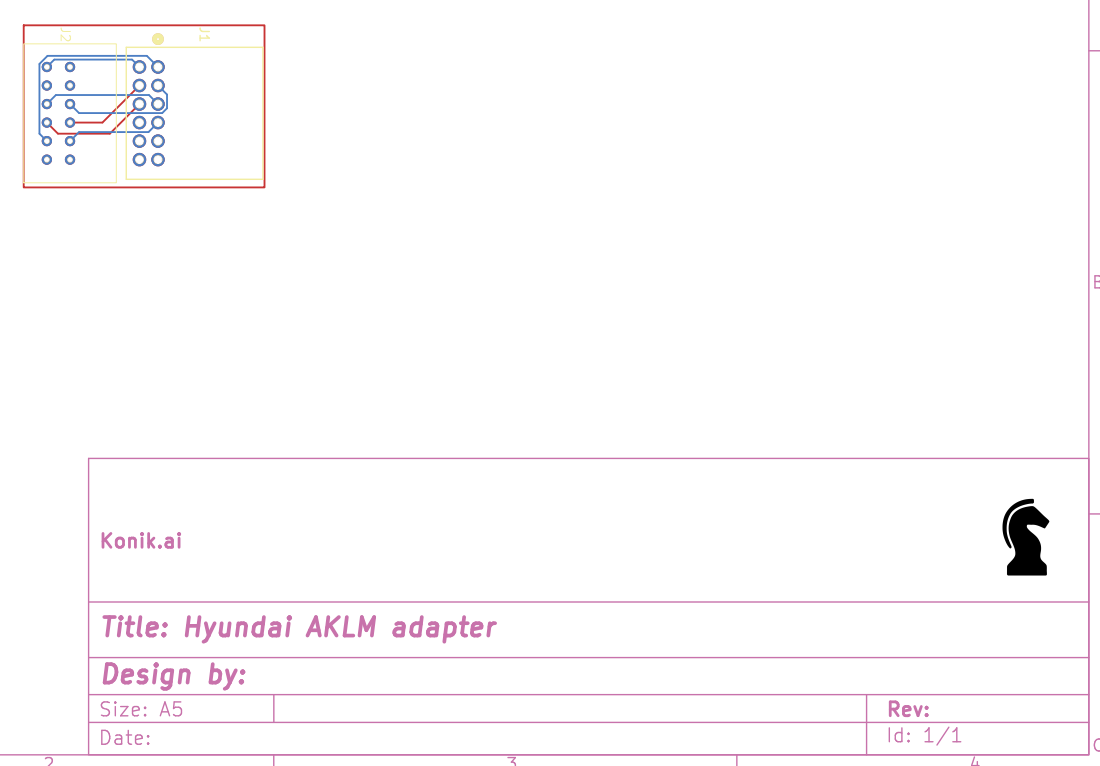
[picture p18: page 1]
