Konik-ai/Konik-openpilot-harness-cables/(commit log)

2025-08-16 [ENCH] Tesla_A schematic
2025-08-17 [ENCH] VW_MEB_Gateway_Harness schematics, fix naming for the Tesla_a
2025-08-24 Rivian-A harness board rev 1.0.0
    [Rivian-A-B_Cu.gbl, Rivian-A-B_Mask.gbs, Rivian-A-B_Paste.gbp, Rivian-A-B_Silkscreen.gbo, Rivian-A-Edge_Cuts.gm1, Rivian-A-F_Cu.gtl, Rivian-A-F_Mask.gts, Rivian-A-F_Paste.gtp]
2025-08-24 Schematic of the Rivian-A
2025-08-28 add Capacitor to the chematics
2025-08-28 Fix libraries path.
    [Rivian-A.kicad_pcb]
2025-08-28 fix isolated coper island, add extra connection for the 12V.
    [Rivian-A.kicad_pcb]
2025-08-28 add C50254 CL31B225KBHNNN
    [Rivian-A.kicad_pcb, Rivian-A.kicad_sch]
2025-08-28 add revision label
    [Rivian-A.kicad_pcb, Rivian-A.kicad_sch]
2025-08-28 remove productioon folder
    [Rivian-A-B_Cu.gbl, Rivian-A-B_Mask.gbs, Rivian-A-B_Paste.gbp, Rivian-A-B_Silkscreen.gbo, Rivian-A-Edge_Cuts.gm1, Rivian-A-F_Cu.gtl, Rivian-A-F_Mask.gts, Rivian-A-F_Paste.gtp]
2025-08-28 removed gnd plane on both side
    [Rivian-A.kicad_pcb]
2025-08-28 Use built in symbol/footprint for the capacitor
    [Rivian-A.kicad_pcb, Rivian-A.kicad_sch]
2025-08-28 Add ${REVISION} and ${CURRENT_DATE} fields to silkscreen text
    [Rivian-A.kicad_pcb]
2025-08-28 Add JLC rotations
    [Rivian-A.kicad_pcb, Rivian-A.kicad_sch]
2025-08-28 Leave just big copper plane
    [Rivian-A.kicad_pcb]
2025-08-28 Drill origin at board corner
    [Rivian-A.kicad_pcb]
2025-09-24 Tesla_A-HW4_V2-Harness + schematics of the harness for the Tesla_A-HW4_V2-Harness
    [Tesla-A_HW4.kicad_pcb, Tesla-A_HW4.kicad_sch]
2026-01-12 add BYD-1, 2, 3, 4, 5, 6
    [Tesla-A_HW4.kicad_pcb]
2026-04-07 Modified Ford Q4
    [Hyundai_adapter_AKLM.kicad_pcb, Hyundai_adapter_AKLM.kicad_sch]
